luispl77/433Screen-SignalHacker/(threads)

Thread 2 (2023-01-25):

Hardware not receiving or transmitting.

jamine16, 2023-01-25:
I have build my device according to your diagrams, but it is not receiving or transmitting any data.
I have triple checked all my connections and they are not the issue.

I selected DOIT ESP32 DEVKIT V1 board in Arduino IDE.

Any help would be appreciated.

Thanks

jamine16, 2023-01-25:
After replacing both RFM modules and all the wiring i found the problem.

In the diagrams it shows the SCK pins of the  SD Card and RFM only connected to each other. After connecting them to pin18 (CLK) on the ESP32, everything is working fine.

luispl77, 2023-05-04:
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

Yes thank you for pointing that out, sorry for the late response. The missing "SCK" NET was fixed in the next PCB version.

Thread 3 (2023-05-28):

Request function-set frequency manually

BG7UHS, 2023-05-28:
Can you add the function of manually setting frequency? Some places need 315Mhz, or other frequencies.

thank you

luispl77, 2023-05-29:
Yes I will use the EEPROM to store all settings, so that they remain after the device is powered off. This means you will only need to change frequency once, in Replay/Store -> Receiver Config. Note that you need to get the right RFM69HW module for the right frequency band, there are [3 different versions](https://pt.aliexpress.com/item/33017904081.html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) :  433/315 MHz, 868 MHz, 915 MHz . If you get a module for 433 MHz and try to use it in 868 MHz band, you will see a significant reduction in efficiency.

BG7UHS, 2023-05-29:
Thank you very much. I'm making PCB. Looking forward to your Android Stm32+cc1101.

Thread 5 (2024-02-11):

Project abandoned??

AlistairXX, 2024-02-11:
Is this project abandoned, I tried finding you on discord but no luck. Let us know. I was thinking of getting the pcb made but before I do that if there’s any new update I would really appreciate to know that.

luispl77, 2024-02-11:
Hello and thank you for the interest in the project, but it is on hold/abandoned at the moment. This is because I am working on something much, much better (Flipper Zero sub-1 functionality for less than 4€ manufacturer cost), but that is still at least a month away from release. This ESP32 based analyser can be quite capable, and if you wish to build it, I can help you with it. Better even, if you could contribute to the code and help complete the functionality, I would be very grateful . My discord username is luispl77.
