luispl77/433Screen-SignalHacker/HARDWARE/Schematic_LPL_ESP32signalhacker_2023-05-05.pdf

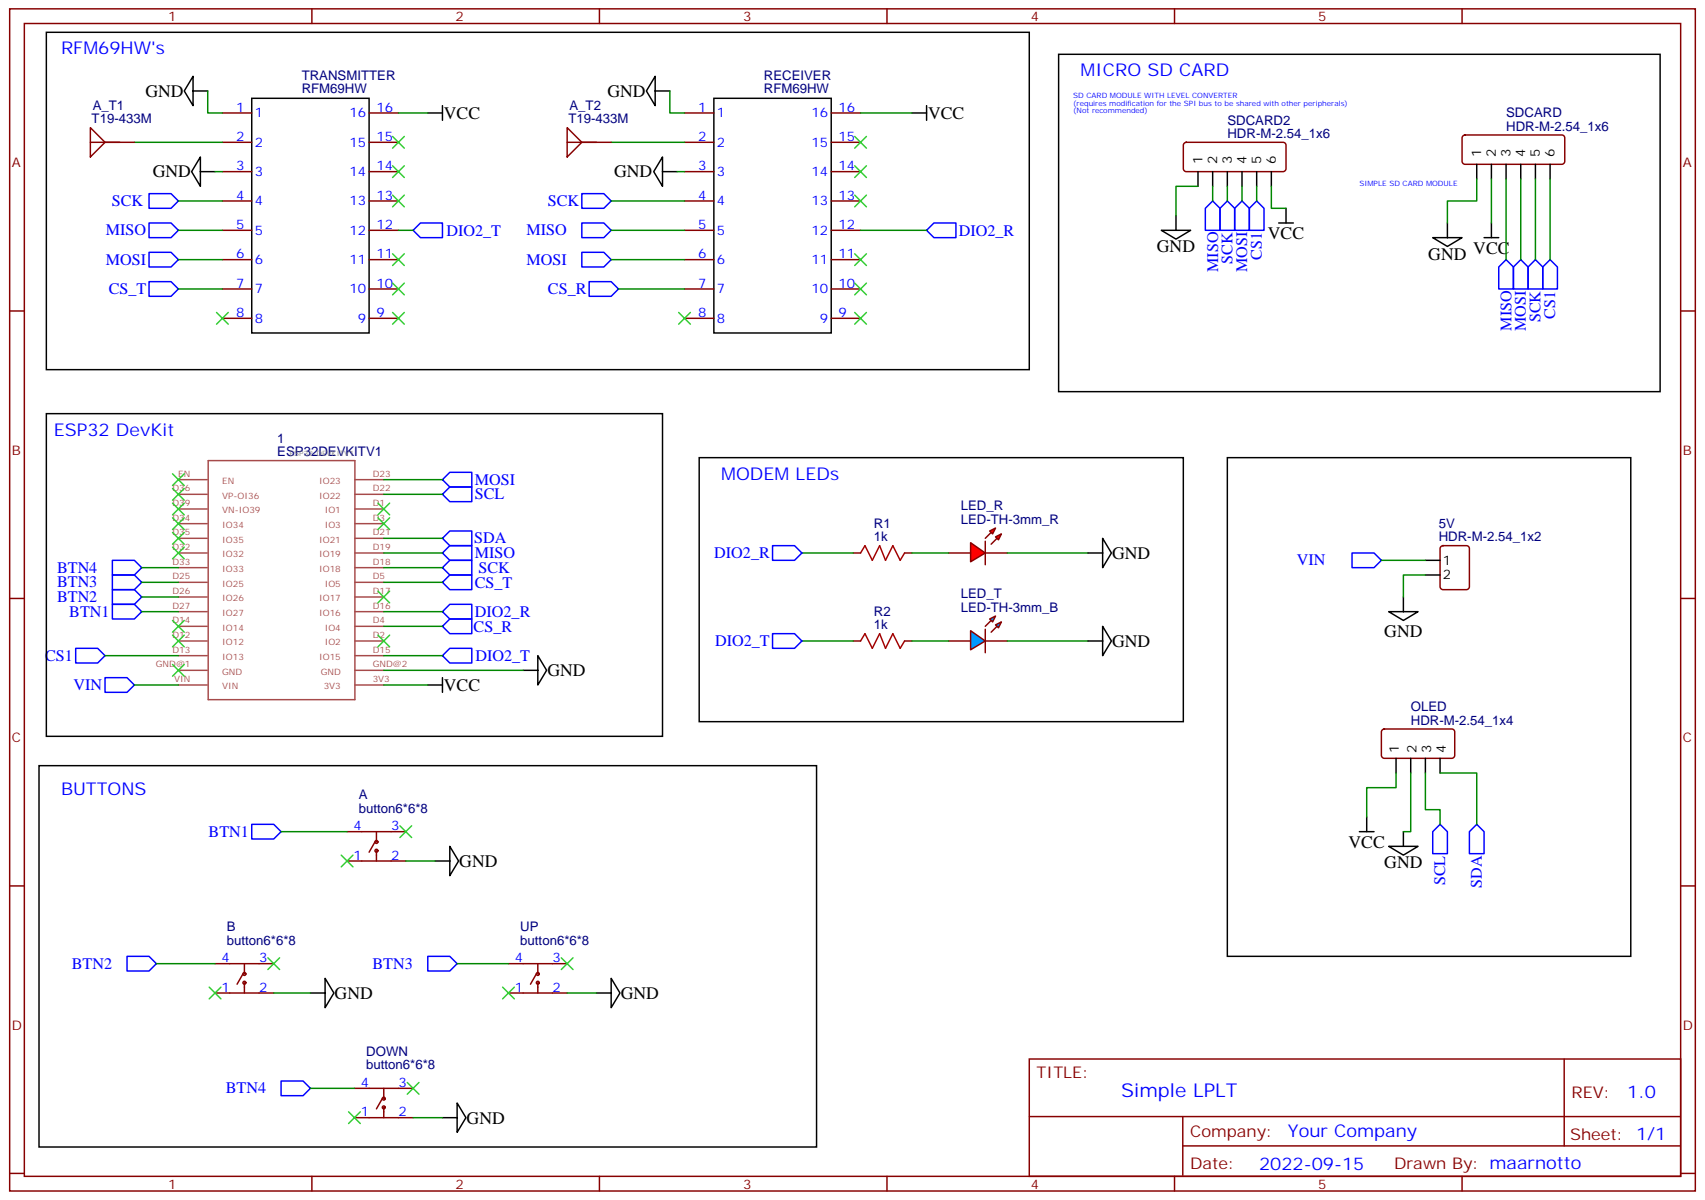
[picture p1: page 1]

SD CARD MODULE WITH LEVEL CONVERTER
(requires modification for the SPI bus to be shared with other peripherals)
(Not recommended)

SIMPLE SD CARD MODULE
