luispl77/433Screen-SignalHacker/(list of files, drawings)

Other design files:
HARDWARE/SCH_LPL_ESP32signalhacker_2023-05-05.json
