luispl77/433Screen-SignalHacker/rolljam.ino

  byte bandwidth[24] = {OOK_BW_1_3, OOK_BW_1_6, OOK_BW_2_0, OOK_BW_2_6, OOK_BW_3_9, OOK_BW_5_2, OOK_BW_6_3,  OOK_BW_7_8, OOK_BW_10_4, OOK_BW_12_5, OOK_BW_15_6, 
                        OOK_BW_20_8, OOK_BW_25_0, OOK_BW_31_3, OOK_BW_41_7, OOK_BW_50_0, OOK_BW_62_5, OOK_BW_83_3, OOK_BW_100_0, OOK_BW_125_0,
                        OOK_BW_166_7, OOK_BW_200_0, OOK_BW_250_0};
  float bw[24] = {1.3, 1.6, 2.0, 2.6, 3.9, 5.2, 6.3, 7.8, 10.4, 12.5, 15.6, 20.8, 25.0, 31.3, 41.7, 50.0, 62.5, 83.3, 100.0, 125.0, 166.7, 200.0, 250.0};

  byte lna_gain[7] = {RF_LNA_GAINSELECT_AUTO, RF_LNA_GAINSELECT_MAX, RF_LNA_GAINSELECT_MAXMINUS6, RF_LNA_GAINSELECT_MAXMINUS12, RF_LNA_GAINSELECT_MAXMINUS24,
                      RF_LNA_GAINSELECT_MAXMINUS36, RF_LNA_GAINSELECT_MAXMINUS48};
  String lg[7] = {"AUTO", "MAX", "MAX-6", "MAX-12", "MAX-24", "MAX-36", "MAX-48"};
  
  byte modulation[2] = {RF_DATAMODUL_DATAMODE_CONTINUOUSNOBSYNC | RF_DATAMODUL_MODULATIONTYPE_OOK | RF_DATAMODUL_MODULATIONSHAPING_00,
                        RF_DATAMODUL_DATAMODE_CONTINUOUSNOBSYNC | RF_DATAMODUL_MODULATIONTYPE_FSK| RF_DATAMODUL_MODULATIONSHAPING_00};
  String mod[2] = {"OOK", "FSK"};
  
  int bw_cursor = 18;
  int lna_cursor = 1;
  int mod_cursor = 0;
  int dev_cursor = 0;
  int _cursor = 0; int max_cursor = 5;
  float frequency = 433.920;
  float frequency_dev = 5000;
  int fixedThreshold = 10;
void rollJam(){
  rolljam.drawText(String(frequency, 3), 0, 0, 1, NORMAL);
  rolljam.drawText(String(fixedThreshold), 0, 10, 1, NORMAL);
  rolljam.drawText(String(bw[bw_cursor]), 0, 20, 1, NORMAL);
  rolljam.drawText(lg[lna_cursor], 0, 30, 1, NORMAL);
  rolljam.drawText(mod[mod_cursor], 0, 40, 1, NORMAL);
  rolljam.drawText(String(frequency_dev), 0, 50, 1, NORMAL);
  while(1){
    if(send_cst.clickA()){
      changeCursor();
      delay(300);
    }
    if(send_cst.clickUP()){
      triggerIncrease();
      delay(200);
    }
    if(send_cst.clickDOWN()){
      triggerDecrease();
      delay(200);
    }
    if(send_cst.clickB()){

      break;
    }
  }
}

void changeCursor(){
  _cursor++; if(_cursor == max_cursor + 1) _cursor = 0;
  rolljam.updateText("   ", 50, (_cursor == 0) ? max_cursor*10 : (_cursor * 10  - 10), 1, NORMAL, 3);
  rolljam.drawText("<", 50, 10*_cursor, 1, NORMAL);
}

void triggerIncrease(){
  if(_cursor == 0){
    frequency += 0.001; radio_R.setFrequencyMHz(frequency);
    rolljam.updateText(String(frequency, 3), 0, 0, 1, NORMAL, 8);
  }
  else if(_cursor == 1){
    fixedThreshold++; radio_R.setFixedThreshold(fixedThreshold); 
    rolljam.updateText(String(fixedThreshold), 0, 10, 1, NORMAL, 8);
  }
  else if(_cursor == 2){
    bw_cursor++; if(bw_cursor > 22) bw_cursor = 0;
    radio_R.setBandwidth(bandwidth[bw_cursor]);
    rolljam.updateText(String(bw[bw_cursor]), 0, 20, 1, NORMAL, 8);
  }
  else if(_cursor == 3){
    lna_cursor++; if(lna_cursor > 6) lna_cursor = 0;
    radio_R.writeReg(REG_LNA, RF_LNA_ZIN_50 | lna_gain[lna_cursor]);
    rolljam.updateText(lg[lna_cursor], 0, 30, 1, NORMAL, 8);
  }
  else if(_cursor == 4){
    mod_cursor++; if(mod_cursor > 1) mod_cursor = 0;
    radio_R.writeReg(REG_DATAMODUL, modulation[mod_cursor]);
    rolljam.updateText(mod[mod_cursor], 0, 40, 1, NORMAL, 8);
  }
  if(_cursor == 5){
    if(frequency_dev < 300000) frequency_dev += 500;
    radio_R.setFrequencyDev(frequency_dev);
    rolljam.updateText(String(frequency_dev), 0, 50, 1, NORMAL, 8);
  }
}

void triggerDecrease(){
  if(_cursor == 0){
    frequency -= 0.001; radio_R.setFrequencyMHz(frequency);
    rolljam.updateText(String(frequency, 3), 0, 0, 1, NORMAL, 8);
  }
  else if(_cursor == 1){
    fixedThreshold--; radio_R.setFixedThreshold(fixedThreshold); 
    rolljam.updateText(String(fixedThreshold), 0, 10, 1, NORMAL, 8);
  }
  else if(_cursor == 2){
    bw_cursor--; if(bw_cursor < 0) bw_cursor = 22;
    radio_R.setBandwidth(bandwidth[bw_cursor]);
    rolljam.updateText(String(bw[bw_cursor]), 0, 20, 1, NORMAL, 8);
  }
  else if(_cursor == 3){
    lna_cursor--; if(lna_cursor < 0) lna_cursor = 6;
    radio_R.writeReg(REG_LNA, RF_LNA_ZIN_50 | lna_gain[lna_cursor]);
    rolljam.updateText(lg[lna_cursor], 0, 30, 1, NORMAL, 8);
  }
  else if(_cursor == 4){
    mod_cursor--; if(mod_cursor < 0) mod_cursor = 1;
    radio_R.writeReg(REG_DATAMODUL, modulation[mod_cursor]);
    rolljam.updateText(mod[mod_cursor], 0, 40, 1, NORMAL, 8);
  }
  if(_cursor == 5){
    if(frequency_dev > 1500) frequency_dev -= 500;
    radio_R.setFrequencyDev(frequency_dev);
    rolljam.updateText(String(frequency_dev), 0, 50, 1, NORMAL, 8);
  }
}
