luispl77/433Screen-SignalHacker/433Screen-SignalHacker/sendSquareWave.ino

void sendSquareWave(){
  int dbm = radio_T._dbm;
  int scw_cursor = 0;
  uint32_t frequency = 2500;
  bool onOff = false;
  send_sqr.drawText("frequency:", 0, 20, 1, INVERS); send_cst.drawText(String(frequency), 63, 20, 1, NORMAL);
  send_sqr.drawText("dbm: ", 0, 40, 1, NORMAL); send_cst.drawText(String(dbm), 27, 40, 1, NORMAL);
  send_sqr.drawText("SEND", 80, 50, 1, NORMAL);
  radio_T.setTransmitPower(dbm, PA_MODE_PA1_PA2_20dbm, OCP_OFF);
  radio_T.txBegin();
  ledcSetup(0, frequency, 8);
  ledcAttachPin(DIO2_T, 0);
  delay(200);
  while(1){
    if(send_sqr.clickA()){
      rotate_sqr(&scw_cursor);
      delay(300);
    }
    if(send_sqr.clickUP()){
      increase_dbm_frequency_sqr(&scw_cursor, &frequency, &dbm);
      delay(200);
    }
    if(send_sqr.clickDOWN()){
      decrease_dbm_frequency_sqr(&scw_cursor, &frequency, &dbm);
      delay(200);
    }
    if(send_sqr.clickB()){
      //ledOff();
      //radio_R.send(0);
      //radio_R.standby();
      pushEEPROMSettings(); //save changes
      break; 
    }
  }
}

void increase_dbm_frequency_sqr(int * scw_cursor, uint32_t *frequency, int* dbm){
  if(*scw_cursor == 0){
    (*frequency) = (*frequency) + 10; ledcSetup(0, *frequency, 8);
    Serial.println(*frequency); send_sqr.updateText(String(*frequency), 63, 20, 1, NORMAL, 8);
  }
  if(*dbm < 20 && *scw_cursor == 1){
    (*dbm)++; radio_T.setTransmitPower(*dbm, PA_MODE_PA1_PA2_20dbm, OCP_OFF);
    Serial.println(*dbm); send_sqr.updateText(String(*dbm), 27, 40, 1, NORMAL, 2);
  }
  if(*scw_cursor == 2){
    ledOn();
    ledcWrite(0, 127);
  }
}

void decrease_dbm_frequency_sqr(int * scw_cursor, uint32_t *frequency, int* dbm){
  if(*scw_cursor == 0){
    (*frequency) = (*frequency) - 10; ledcSetup(0, *frequency, 8);
    Serial.println(*frequency); send_sqr.updateText(String(*frequency), 63, 20, 1, NORMAL, 8);
  }
  if(*dbm > 5 && *scw_cursor == 1){
    (*dbm)--; radio_T.setTransmitPower(*dbm, PA_MODE_PA1_PA2_20dbm, OCP_OFF);
    Serial.println(*dbm); send_sqr.updateText(String(*dbm), 27, 40, 1, NORMAL, 2);
  }
  if(*scw_cursor == 2){
    ledOff();
    ledcWrite(0, 0);
  }
}

void rotate_sqr(int * scw_cursor){
  (*scw_cursor)++;
  if(*scw_cursor == 3) *scw_cursor = 0;
      if(*scw_cursor == 0){
        send_sqr.updateText("frequency:", 0, 20, 1, INVERS, 9); //Serial.println("updated freq");      
        send_sqr.updateText("SEND", 80, 50, 1, NORMAL, 5);
      }
      if(*scw_cursor == 1){
        send_sqr.updateText("dbm:", 0, 40, 1, INVERS, 3);//Serial.println("updated dbm"); //update current 
        send_sqr.updateText("frequency:", 0, 20, 1, NORMAL, 12); //normalize previous
        
      }
      if(*scw_cursor == 2){
        send_sqr.updateText("SEND", 80, 50, 1, INVERS, 5); //Serial.println("updated SEND");
        send_sqr.updateText("dbm:", 0, 40, 1, NORMAL, 5);
        
      }
}
