luispl77/433Screen-SignalHacker/rc_car.ino

void carMode(){
  initialize_radio_car();
  car_mode.drawText("A: right", 0, 0, 1, NORMAL);
  car_mode.drawText("B: left", 0, 10, 1, NORMAL);
  car_mode.drawText("UP: forward", 0, 20, 1, NORMAL);
  car_mode.drawText("DOWN: backward", 0, 30, 1, NORMAL);
  
  car_mode.drawText("EN: reboot/exit", 0, 50, 1, NORMAL);
  
  while(1){
    if(car_mode.clickA()){
     pulse(900);
    }
    if(!car_mode.clickA() && !car_mode.clickB()){
      pulse(1100); 
    }
    if(car_mode.clickB()){
      pulse(1300); 
    }
    
    
    
    if(car_mode.clickUP()){
      pulse(1500); 
    }
    if(!car_mode.clickUP() && !car_mode.clickDOWN()){
     pulse(1700); 
    }
    if(car_mode.clickDOWN()){
     pulse(1900); 
    }
     
  }
}




void speed50(){
  initialize_radio_car();
  for(int i = 0; i < 20; i++) pulse(2750);
}

void speed60(){
  initialize_radio_car();
  for(int i = 0; i < 20; i++) pulse(3250);
}

void speed70(){
  initialize_radio_car();
  for(int i = 0; i < 20; i++) pulse(3750);
}

void speed80(){
  initialize_radio_car();
  for(int i = 0; i < 20; i++) pulse(4250);
}

void speed90(){
  initialize_radio_car();
  for(int i = 0; i < 20; i++) pulse(4750);
}

void speed100(){
  initialize_radio_car();
  for(int i = 0; i < 20; i++) pulse(5250);
}

void pulse(int duration) {
  digitalWrite(DIO2_R, LOW);
  delayMicroseconds(duration); // % 1000); delay(duration / 1000);
  digitalWrite(DIO2_R, HIGH);
  delayMicroseconds(duration); // % 1000); delay(duration / 1000);

  digitalWrite(DIO2_R, LOW);
  delayMicroseconds(duration); // % 1000); delay(duration / 1000);
  digitalWrite(DIO2_R, HIGH);
  delayMicroseconds(duration); // % 1000); delay(duration / 1000);
}

void initialize_radio_car(){
  radio_R.setMode(RF69OOK_MODE_STANDBY);
  radio_R.setFrequencyMHz(frequency_ISM);
  radio_R.setTransmitPower(21, PA_MODE_PA1_PA2_20dbm, OCP_OFF);
  radio_R.initializeTransmit();
  radio_R.setModulationType(MOD_FSK); radio_R.setFrequencyDev(10000);
}
