luispl77/433Screen-SignalHacker/sendConstantWave.ino

void sendConstantWave(){
  int dbm = 10;
  int scw_cursor = 0;
  float frequency = 433.920;
  bool onOff = false;
  send_cst.drawText("frequency:", 0, 20, 1, INVERS); send_cst.drawText(String(frequency, 3), 63, 20, 1, NORMAL);
  send_cst.drawText("dbm: ", 0, 40, 1, NORMAL); send_cst.drawText(String(dbm), 27, 40, 1, NORMAL);
  send_cst.drawText("SEND", 80, 50, 1, NORMAL);
  radio_T.setModulationType(MOD_OOK);
  radio_T.setFrequencyMHz(frequency); Serial.println("frequency set.");
  radio_T.setTransmitPower(dbm, PA_MODE_PA1_PA2_20dbm, OCP_OFF);
  radio_T.initializeTransmit();
  delay(200);
  while(1){
    if(send_cst.clickA()){
      rotate(&scw_cursor);
      delay(300);
    }
    if(send_cst.clickUP()){
      increase_dbm_frequency(&scw_cursor, &frequency, &dbm);
      delay(200);
    }
    if(send_cst.clickDOWN()){
      decrease_dbm_frequency(&scw_cursor, &frequency, &dbm);
      delay(200);
    }
    if(send_cst.clickB()){
      ledOff();
      radio_T.send(0);
      radio_T.standby();
      break;
    }
  }
}

void increase_dbm_frequency(int * scw_cursor, float *frequency, int* dbm){
  if(*scw_cursor == 0){
    (*frequency) = (*frequency) + 0.001; radio_T.setFrequencyMHz(*frequency);
    Serial.println(*frequency); send_cst.updateText(String(*frequency, 3), 63, 20, 1, NORMAL, 8);
  }
  if(*dbm < 20 && *scw_cursor == 1){
    (*dbm)++; radio_T.setTransmitPower(*dbm, PA_MODE_PA1_PA2_20dbm, OCP_OFF);
    Serial.println(*dbm); send_cst.updateText(String(*dbm), 27, 40, 1, NORMAL, 2);
  }
  if(*scw_cursor == 2){
    ledOn();
    radio_T.send(1);
  }
}

void decrease_dbm_frequency(int * scw_cursor, float *frequency, int* dbm){
  if(*scw_cursor == 0){
    (*frequency) = (*frequency) - 0.001; radio_T.setFrequencyMHz(*frequency);
    Serial.println(*frequency); send_cst.updateText(String(*frequency, 3), 63, 20, 1, NORMAL, 8);
  }
  if(*dbm > 5 && *scw_cursor == 1){
    (*dbm)--; radio_T.setTransmitPower(*dbm, PA_MODE_PA1_PA2_20dbm, OCP_OFF);
    Serial.println(*dbm); send_cst.updateText(String(*dbm), 27, 40, 1, NORMAL, 2);
  }
  if(*scw_cursor == 2){
    ledOff();
    radio_T.send(0);
  }
}

void rotate(int * scw_cursor){
  (*scw_cursor)++;
  if(*scw_cursor == 3) *scw_cursor = 0;
      if(*scw_cursor == 0){
        send_cst.updateText("frequency:", 0, 20, 1, INVERS, 9); Serial.println("updated freq");      
        send_cst.updateText("SEND", 80, 50, 1, NORMAL, 5);
      }
      if(*scw_cursor == 1){
        send_cst.updateText("dbm:", 0, 40, 1, INVERS, 3);Serial.println("updated dbm"); //update current 
        send_cst.updateText("frequency:", 0, 20, 1, NORMAL, 12); //normalize previous
        
      }
      if(*scw_cursor == 2){
        send_cst.updateText("SEND", 80, 50, 1, INVERS, 5); Serial.println("updated SEND");
        send_cst.updateText("dbm:", 0, 40, 1, NORMAL, 5);
        
      }
}
