luispl77/433Screen-SignalHacker/(commit log)

2022-11-02 starting rfm69LPL custom library code
    changed the name from rfm69ook to rf69lpl, removed interrupt pins, and other interrupt functions. cleaned up code brackets and comments.
2022-11-04 added hardware folder with gerber PCB files
2022-11-04 added UI1306LPL library and first function to work on: signal jammer
    [433Screen-SignalHacker.ino]
2022-11-14 sendConstantWave() finished
    added all basic functionality for sending a wave and being able output power and frequency in real time
2022-11-14 added prototype for spectrumAnalyser function
    still need to develop the code
2022-11-19 spectrum analyser, added rssivalue print
2022-12-08 fixed initialization of the radio
    [rc_car.ino]
2022-12-10 added replayRecord mode, with bugs
    [433Screen-SignalHacker.ino, RecordNReplay.ino]
2022-12-11 added some important links to the tesla charging port hack
2023-01-07 added led analyser
2023-01-08 added battery voltage indicator (shows reading after boot screen)
2023-01-19 ficxed battery ofset and minus sign in frequency++
2023-05-04 Hardware version 1.1; Firmware is under development.
    PCB: Added ground plane to improve antenna performance; added LEDs on the MODEM pins; added pins for another SD card module; fixed SCK NET missing (issue #2 );
2023-05-04 updated hardware folder.
    [SCH_LPL_ESP32signalhacker_2023-05-05.json]
2023-05-29 changed record/replay from cyclic checks to interrupt based
    first version of the interrupt based recording. It checks for a state change, but next I will try to check for rising and falling edge. The results are not very good, it manages to record the tesla signal uncorrupted about half the time.
2023-05-29 fixed record/replay
    tested rescording tesla signal and replaying it. it records with decent accuracy. 400 us pulse comes sometimes short 381us or long, 420us
    [RecordNReplay.ino]
2023-06-02 added EEPROM functionality for saving settings.
    added ability to remember 13 registers of radio settings after power off.
2023-06-04 changed all file names, organized files and modes
    added battery mode, to get a voltage reading on pin 35, changed all file names
2023-06-04 fixed bug with first eeprom settings write
    [433Screen-SignalHacker.ino, EEPROM_SETTINGS.ino]
2023-06-04 fixed bug where transmitter started transmitting at boot
    [433Screen-SignalHacker.ino, EEPROM_SETTINGS.ino]
2023-06-05 removed square wave jamming mode temporarily, to restructure the modes
    also added frequency to the screen on tesla mode, and the tesla mode now uses the receiver module to transmitt
    [433Screen-SignalHacker.ino, CONFIG_RECEIVER.ino, CUSTOM_MODES.ino, JAMMER_CONFIG.ino, JAMMING.ino]
2023-06-05 fixed graphical analyser not putting in standby on exit
    [GRAPHIC_ANALYSER.ino]
2023-06-08 added 2 new jamming modes, square wave and sweep mode.
    [JAMMER_CONFIG.ino, JAMMING.ino]
2023-06-08 added pulse counter in receiver config, removed LED interrupt.
2023-07-10 record/replay now records on button press and not hold.
2024-02-12 fix index issue preventing compile
    [RECORD_REPLAY.ino]
